emeb/adsb_cape/README.md

adsb_cape
=========

Hardware and software for a Beaglebone-based ADS-B receiver. More details
about the design are at the following site:

http://ebrombaugh.studionebula.com/radio/adsb-cape/index.html

LICENSE
=======

This project is provided under the Creative Commons Attribution-ShareAlike
4.0 International (CC BY-SA 4.0) license. For details see here:

http://creativecommons.org/licenses/by-sa/4.0/

Eric Brombaugh 07/15/2014
