emeb/adsb_cape/documents/bom.ods

refdes | device | value | footprint | Qty | Tot Qty | Mfg P/N | Distributor | Distributor P/N | Price | tot. Price
C415 | CAPACITOR | 0.001uf | my_0603 | 1 | 1 | GRM1885C1H102JA01D | Digi-Key | 490-1451-1-ND | 0.045 | 0.045
C211 | CAPACITOR | 0.01uF | my_0603 | 1
C407 | CAPACITOR | 0.01uf | my_0603 | 1 | 2 | C0603C103K5RACTU | Digi-Key | 399-1091-1-ND | 0.014 | 0.028
C413 | CAPACITOR | 0.022uf | my_0603 | 1 | 1 | CL10B223KB8SFNC | Digi-Key | 1276-2004-1-ND | 0.0156 | 0.0156
C104 | CAPACITOR | 0.1uf | my_0603 | 1
C201 | CAPACITOR | 0.1uf | my_0603 | 1
C202 | CAPACITOR | 0.1uf | my_0603 | 1
C203 | CAPACITOR | 0.1uF | my_0603 | 1
C204 | CAPACITOR | 0.1uF | my_0603 | 1
C206 | CAPACITOR | 0.1uF | my_0603 | 1
C207 | CAPACITOR | 0.1uF | my_0603 | 1
C208 | CAPACITOR | 0.1uF | my_0603 | 1
C210 | CAPACITOR | 0.1uF | my_0603 | 1
C213 | CAPACITOR | 0.1uf | my_0603 | 1
C301 | CAPACITOR | 0.1uf | my_0603 | 1
C302 | CAPACITOR | 0.1uf | my_0603 | 1
C303 | CAPACITOR | 0.1uf | my_0603 | 1
C304 | CAPACITOR | 0.1uf | my_0603 | 1
C305 | CAPACITOR | 0.1uf | my_0603 | 1
C306 | CAPACITOR | 0.1uf | my_0603 | 1
C307 | CAPACITOR | 0.1uf | my_0603 | 1
C308 | CAPACITOR | 0.1uf | my_0603 | 1
C309 | CAPACITOR | 0.1uf | my_0603 | 1
C310 | CAPACITOR | 0.1uf | my_0603 | 1
C311 | CAPACITOR | 0.1uf | my_0603 | 1
C312 | CAPACITOR | 0.1uf | my_0603 | 1
C313 | CAPACITOR | 0.1uf | my_0603 | 1
C401 | CAPACITOR | 0.1uF | my_0603 | 1
C405 | CAPACITOR | 0.1uF | my_0603 | 1
C408 | CAPACITOR | 0.1uf | my_0603 | 1
C414 | CAPACITOR | 0.1uf | my_0603 | 1 | 27 | CC0603KRX7R9BB104 | Digi-Key | 311-1344-1-ND | 0.0125 | 0.3375
C406 | CAPACITOR | 100F | my_0603 | 1
C402 | CAPACITOR | 100pF | my_0603 | 1
C410 | CAPACITOR | 100pf | my_0603 | 1
C411 | CAPACITOR | 100pf | my_0603 | 1
C412 | CAPACITOR | 100pf | my_0603 | 1
C416 | CAPACITOR | 100pf | my_0603 | 1 | 6 | GRM0335C1E101JA01D | Digi-Key | 490-3160-1-ND | 0.0094 | 0.0564
C409 | CAPACITOR | 10uf | my_0805 | 1
C101 | CAPACITOR | 10uF 25V | my_0805 | 1
C102 | CAPACITOR | 10uF 25V | my_0805 | 1
C103 | CAPACITOR | 10uF 25V | my_0805 | 1
C205 | CAPACITOR | 10uF 25V | my_0805 | 1
C212 | CAPACITOR | 10uF 25V | my_0805 | 1 | 6 | CL21A106KAYNNNE | Digi-Key | 1276-2891-1-ND | 0.25 | 1.5
C209 | CAPACITOR | 1uF | my_0603 | 1 | 1 | UMK107AB7105KA-T | Digi-Key | 587-3247-1-ND | 0.194 | 0.194
C403 | CAPACITOR | 47nF | my_0603 | 1
C404 | CAPACITOR | 47nF | my_0603 | 1 | 2 | CL10B473KB8NNNC | Digi-Key | 1276-1063-1-ND | 0.0164 | 0.0328
ESD401 | DIODE | PESD0603-240 | my_0603 | 1 | 1 | PESD0603-240 | Digi-Key | PESD0603-240CT-ND | 0.138 | 0.138
J102 | HEADER46 | unknown | HEADER46_2 | 1
J103 | HEADER46 | unknown | HEADER46_2 | 1 | 2 | Beaglebone Header Set | Adafruit | 706 | 4.95 | 4.95
J301 | CONNECTOR_6 | unknown | JUMPER6 | 1 | 1 | Misc 0.1” breakaway | generic |  | 0.1 | 0.1
J401 | BNC | unknown | SMA_ENDLAUNCH | 1 | 1 | 142-0701-801 | Digi-Key | J502-ND | 5.09 | 5.09
L401 | INDUCTOR | 82nH | my_0805 | 1
L402 | INDUCTOR | 82nH | my_0805 | 1 | 2 | MLF2012D82NMT000 | Digi-Key | 445-1034-1-ND | 0.16 | 0.32
L403 | INDUCTOR | CIM10J102NC | my_0603 | 1 | 1 | CIM10J102NC | Digi-Key | 1276-6378-1-ND | 0.031 | 0.031
LED301 | LED | unknown | 805_pol | 1
LED302 | LED | unknown | 805_pol | 1
LED303 | LED | unknown | 805_pol | 1
LED304 | LED | unknown | 805_pol | 1 | 4 | LTST-C171GKT | Digi-Key | 160-1423-1-ND | 0.238 | 0.952
Q201 | MMBT2222A | unknown | SOT23D | 1 | 1 | MMBT2222A-TP | Digi-Key | MMBT2222ATPMSCT-ND | 0.127 | 0.127
R403 | RESISTOR | 0 | my_0603 | 1 | 1 | MCR03ERTJ000 | Digi-Key | RHM0.0CGCT-ND | 0.0042 | 0.0042
R306 | RESISTOR | 100 | my_0603 | 1
R307 | RESISTOR | 100 | my_0603 | 1
R308 | RESISTOR | 100 | my_0603 | 1 | 3 | CR0603-FX-1000ELF | Digi-Key | CR0603-FX-1000ELFCT-ND | 0.0187 | 0.0561
R202 | RESISTOR | 220 | my_0603 | 1 | 1 | CR0603-FX-2200ELF | Digi-Key | CR0603-FX-2200ELFCT-ND | 0.0187 | 0.0187
R301 | RESISTOR | 330 | my_0603 | 1
R303 | RESISTOR | 330 | my_0603 | 1
R309 | RESISTOR | 330 | my_0603 | 1
R310 | RESISTOR | 330 | my_0603 | 1 | 4 | CR0603-FX-3300ELF |  | CR0603-FX-3300ELFCT-ND | 0.0187 | 0.0748
R201 | RESISTOR | 0 - DNI | my_0603 | 1 | 0 |  |  |  | 0 | 0
R305 | RESISTOR | 1k | my_0603 | 1 | 1 | CR0603-FX-1001ELF | Digi-Key | CR0603-FX-1001ELFCT-ND | 0.0187 | 0.0187
R404 | RESISTOR | 22.1 1% | my_0603 | 1
R406 | RESISTOR | 22.1 1% | my_0603 | 1 | 2 | CR0603-FX-22R1ELF | Digi-Key | CR0603-FX-22R1ELF | 0.0187 | 0.0374
R405 | RESISTOR | 32.4 1% | my_0603 | 1 | 1 | ERJ-3EKF32R4V | Digi-Key | P32.4HCT-ND | 0.0114 | 0.0114
R103 | RESISTOR | 4.7k | my_0603 | 1
R104 | RESISTOR | 4.7k | my_0603 | 1
R302 | RESISTOR | 4.7k | my_0603 | 1
R304 | RESISTOR | 4.7k | my_0603 | 1 | 4 | CR0603-FX-4701ELF | Digi-Key | CR0603-FX-4701ELFCT-ND | 0.0187 | 0.0748
R101 | RESISTOR | 5.6k | my_0603 | 1
R102 | RESISTOR | 5.6k | my_0603 | 1 | 2 | CR0603-FX-5601ELF | Digi-Key | CR0603-FX-5601ELFCT-ND | 0.0187 | 0.0374
R401 | RESISTOR | 60 1% | my_0603 | 1 | 1 | CR0603-FX-60R4ELF | Digi-Key | CR0603-FX-60R4ELFCT-ND
R402 | RESISTOR | DNI | my_0603 | 1 | 0 |  |  |  | 0 | 0
SH401 | SHIELD | unknown | SHIELD-650-650_Lairdtech | 1
SH402 | SHIELD | unknown | SHIELD-650-650_Lairdtech | 1 | 2 | BMI-S-202-F | Digi-Key | 903-1051-1-ND | 1.51 | 3.02
SW101 | SWITCH_DIP2 | unknown | cts_218_2 | 1 | 1 | 218-2LPST | Digi-Key | CT2182LPST-ND | 1.06 | 1.06
U101 | TLV1117 | 3.3V | SOT223 | 1 | 1 | TLV1117-33CDCYR | Digi-Key | 296-21112-1-ND | 0.66 | 0.66
U103 | ZLDO1117 | 1.2V | SOT223 | 1 | 1 | ZLDO1117G12TA | Digi-Key | ZLDO1117G12DICT-ND | 0.54 | 0.54
U104 | 24C256W | unknown | SO8 | 1 | 1 | FT24C256A-USR-T | Digi-Key | 1219-1098-1-ND | 0.7 | 0.7
U201 | PCF8574_TS | unknown | SSOP20 | 1 | 1 | PCF8574TS/3,118 | Digi-Key | 568-1078-1-ND | 1.3 | 1.3
U202 | 636L3C020M00000 | unknown | OSC_636 | 1 | 1 | 636L3C020M00000 | Digi-Key | CTX694CT-ND | 1.37 | 1.37
U203 | AD9200 | unknown | TSSOP28 | 1 | 1 | AD9200JRSZ | Digi-Key | AD9200JRSZ-ND | 5.92 | 5.92
U204 | LP2985 | unknown | SOT23-95P-280L1-5N__LTC_S5_Package | 1 | 1 | LP2985-33DBVR | Digi-Key | 296-18476-1-ND | 0.62 | 0.62
U301 | XC3S200A | unknown | LQFP100_14 | 1 | 1 | XC3S200A-4VQG100C | Digi-Key | 122-1594-ND | 12.37 | 12.37
U401 | ADL5513 | unknown | LFCSP_VQ16 | 1 | 1 | ADL5513ACPZ-R7 | Digi-Key | ADL5513ACPZ-R7CT-ND | 11.55 | 11.55
U402 | PSA4-5043+ | unknown | MINICIRCUITS_MMM1362 | 1 | 1 | PSA4-5043+ | Mini-Circuits | PSA4-5043+ | 2.58 | 2.58
U403 | TA1090EC | unknown | TA1090EC | 1 | 1 | TA1090EC | 1090 MHZ-SHOP | 55002 | 12.95 | 12.95
U404 | BGM1013 | unknown | SOT363-65P-240L1-6N__On-Semi_419B-Package | 1 | 1 | BGM1013,115 | Mouser | 771-BGM1013-T/R | 0.41 | 0.41
U405 | TA0232A | unknown | TA0232A | 1 | 1 | TA0232A | 1090 MHZ-SHOP | 55003 | 12.95 | 12.95
 |  |  |  |  | 1 | PC Board | OSHPark | N/A | 24.57 | 24.57
 |  |  |  |  |  |  |  |  | Total cost | 106.8208
