emeb/adsb_cape/(list of files, drawings)

Other design files:
hardware/adsb_cape.pcb
