emeb/adsb_cape/(commit log)

2014-07-15 Create hardware directory and check in
    [adsb_cape.pcb, adsb_cape_pg1.sch, adsb_cape_pg2.sch, adsb_cape_pg3.sch]
2014-07-15 Added 4th page with RF
    [adsb_cape_pg1.sch, adsb_cape_pg2.sch, adsb_cape_pg3.sch, adsb_cape_pg4.sch]
2014-07-15 Fix missing switch
    [adsb_cape_pg1.sch]
2014-07-16 Added footprints, started PCB place & route
    [adsb_cape.pcb, adsb_cape_pg4.sch]
2014-07-16 More routing
    [adsb_cape.pcb]
2014-07-16 Remove unused components, fix mask clearance, finish route
    [adsb_cape.pcb, adsb_cape_pg1.sch, adsb_cape_pg3.sch]
2014-07-17 Added 5V Ferrite, Shields
    [adsb_cape.pcb, adsb_cape_pg4.sch]
2014-07-29 added shields
    [adsb_cape.pcb]
2014-08-02 fixed traces broken by move under shields
    [adsb_cape.pcb]
2014-08-03 Cleanup RF
    [adsb_cape.pcb]
2014-08-03 added arcs instead of 45deg, made 50ohm traces more consistent
    [adsb_cape.pcb]
2014-08-03 Cleanup some DRCs
    [adsb_cape.pcb]
2014-08-03 reduced size of Labels to 70% to make space
    [adsb_cape.pcb]
2014-08-04 fix DRCs, fix route style
    [adsb_cape.pcb]
2014-08-04 Update RF chokes, fix mask openings
    [adsb_cape.pcb, adsb_cape_pg4.sch]
2014-08-04 Added buffer and slope setting options
    [adsb_cape_pg2.sch, adsb_cape_pg4.sch]
2014-08-04 Added buffer, scaling
    [adsb_cape.new.pcb, adsb_cape.pcb, adsb_cape_pg2.sch, adsb_cape_pg4.sch]
2014-08-04 Don't want this
    [adsb_cape.new.pcb]
2014-08-04 Fix transistor fp
    [adsb_cape.pcb, adsb_cape_pg2.sch]
2014-08-04 add user2, user3 LEDs, move LEDs to different part of the FPGA
    [adsb_cape_pg3.sch]
2014-08-04 TK added some LEDs, I imported them to layout
    [adsb_cape.pcb, adsb_cape_pg3.sch]
2014-08-04 Routed new LEDs into FPGA
    [adsb_cape.pcb]
2014-08-04 Minor tweaks/cleanups
    [adsb_cape.pcb]
2014-08-04 added USER1,USER2,USER3 designations to new LEDs and cleaned up routing a bit
    [adsb_cape.pcb]
2014-08-04 Re-arrange RF & Analog for better bypass proximity
    [adsb_cape.pcb]
2014-08-04 Added ESD device
    [adsb_cape.pcb, adsb_cape_pg4.sch]
2014-08-04 Tweak JTAG
    [adsb_cape.pcb]
2014-08-04 moved input amp shield
    [adsb_cape.pcb]
2014-08-05 added bonding from top plane to ground
    [adsb_cape.pcb]
2014-08-05 Cleanup DRCs
    [adsb_cape.pcb]
2014-08-05 added copyright notice and moved JTAG text
    [adsb_cape.pcb]
2014-08-06 Added -13.5db Pad to control gain
    [adsb_cape_pg4.sch]
2014-08-06 moved pad to other side of blocking capacitor in case there is bias on input to amp
    [adsb_cape_pg4.sch]
2014-08-06 added pad
    [adsb_cape.pcb]
2014-08-06 1st cut at adding pad to PCB
    [adsb_cape.pcb]
2014-08-06 fix style
    [adsb_cape.pcb]
2014-08-06 placed and routed -13db pad
    [adsb_cape.pcb]
2014-08-09 unified the size of all REFDES to 70%
    [adsb_cape.pcb]
2014-08-09 added OSHW Symbol
    [adsb_cape.pcb]
2014-08-09 added 2nd OSHW Symbol so we can decide which one we like
    [adsb_cape.pcb]
2014-08-09 removed redundant logo
    [adsb_cape.pcb]
2014-08-11 Created Bill of Materials
    [bom.ods]
2014-08-11 Added P9 connections to unused FPGA pins
    [adsb_cape.pcb, adsb_cape_pg1.sch, adsb_cape_pg3.sch]
2014-08-12 added Block/Levels document for Analog Section
    [levels.ods]
2014-08-14 Fix ADC footprint, add some more gnd plane
    [adsb_cape.pcb, adsb_cape_pg2.sch]
2014-08-15 Swapped in new launcher fp, tweak RF routing for clearance
    [adsb_cape.pcb, adsb_cape_pg4.sch]
2014-08-15 narrower center pad on launcher, clean up routing from logamp to adc
    [adsb_cape.pcb]
2014-08-17 Move overlapping refdes, increase clearance on SMA to avoid gnd stubs
    [adsb_cape.pcb]
2014-09-24 Added prototype report
2014-10-26 Fix some bugs, add 6MHz FIR
    [adsb_top.v, pulsedet.v]
